jasepulveda-18/Proyecto_3_arq/evidence/para_informe/figuras_informe/comparacion_layouts.png

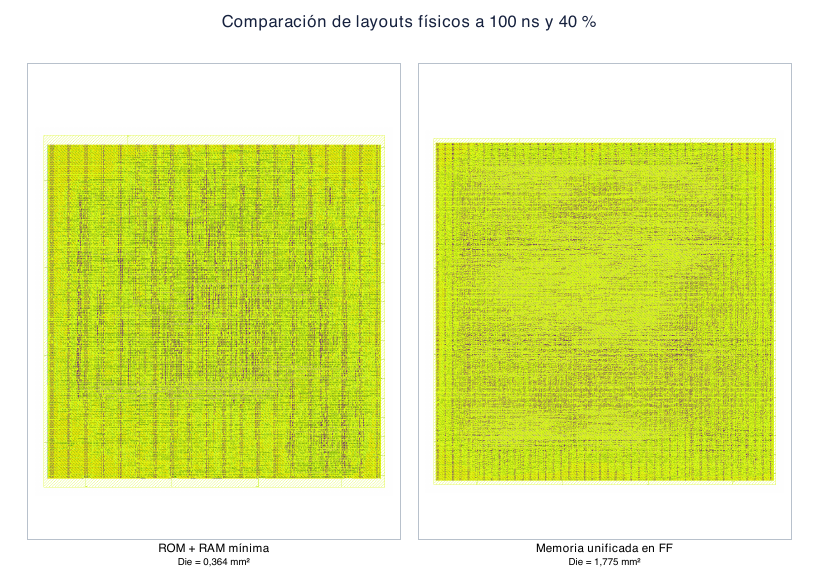
evidence/para_informe/figuras_informe/comparacion_layouts.png
