jasepulveda-18/Proyecto_3_arq/evidence/para_informe/layouts/congestion/rudy_40.png

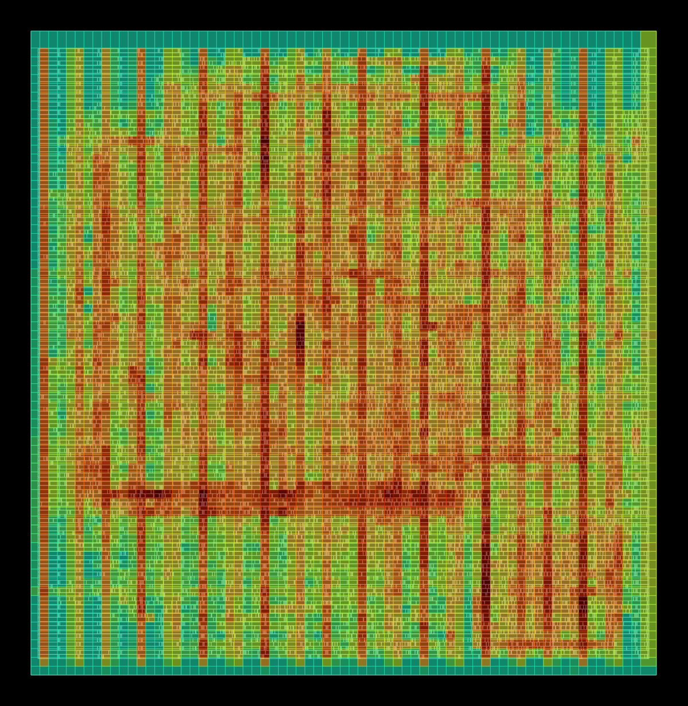
evidence/para_informe/layouts/congestion/rudy_40.png
