jasepulveda-18/Proyecto_3_arq/evidence/para_informe/figuras_informe/barrido_floorplan.pdf

# Barrido de floorplan: utilización frente a violaciones

-0.1

0.0

0.1

0.3

0.4

0.5

36.5673 | 47.8596 | 58.7342

Routing DRC

### Utilización real del core (%)

### Violaciones de routing DRC

Die 0,481 mm² | Die 0,364 mm² | Die 0,294 mm²
