jasepulveda-18/Proyecto_3_arq/evidence/para_informe/figuras_informe/barrido_timing.pdf

Barrido temporal de la estrategia ROM

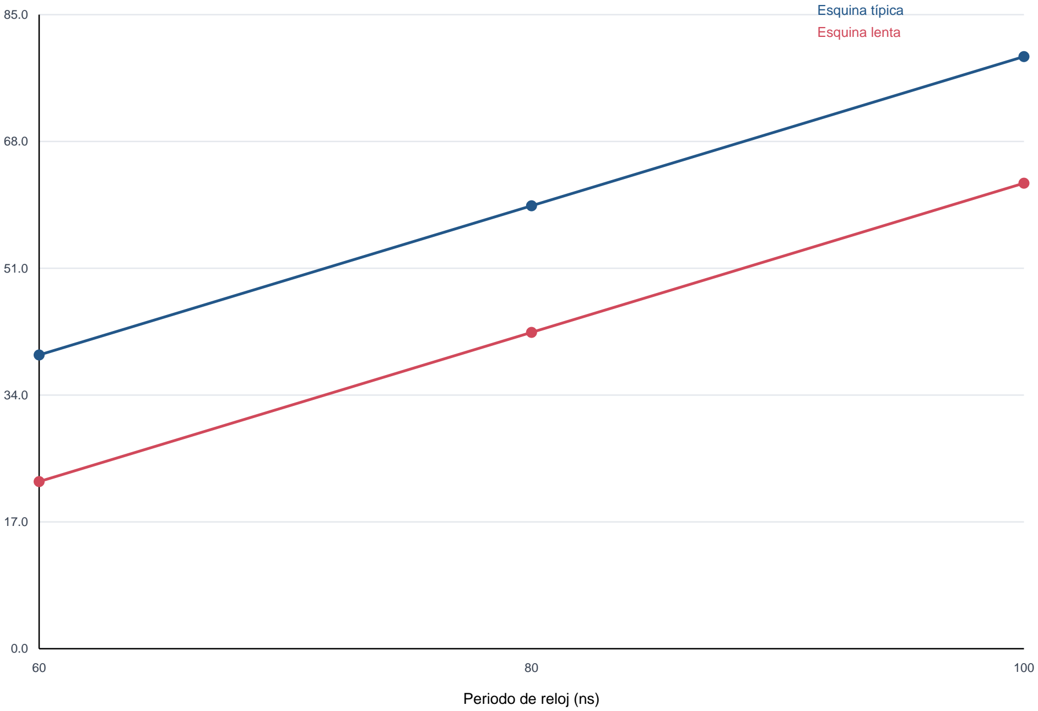
[picture p3: figure]
Esquina típica Esquina lenta; Periodo de reloj (ns)

Holgura real de setup (ns)
