jasepulveda-18/Proyecto_3_arq/evidence/para_informe/figuras_informe/comparacion_layouts.pdf

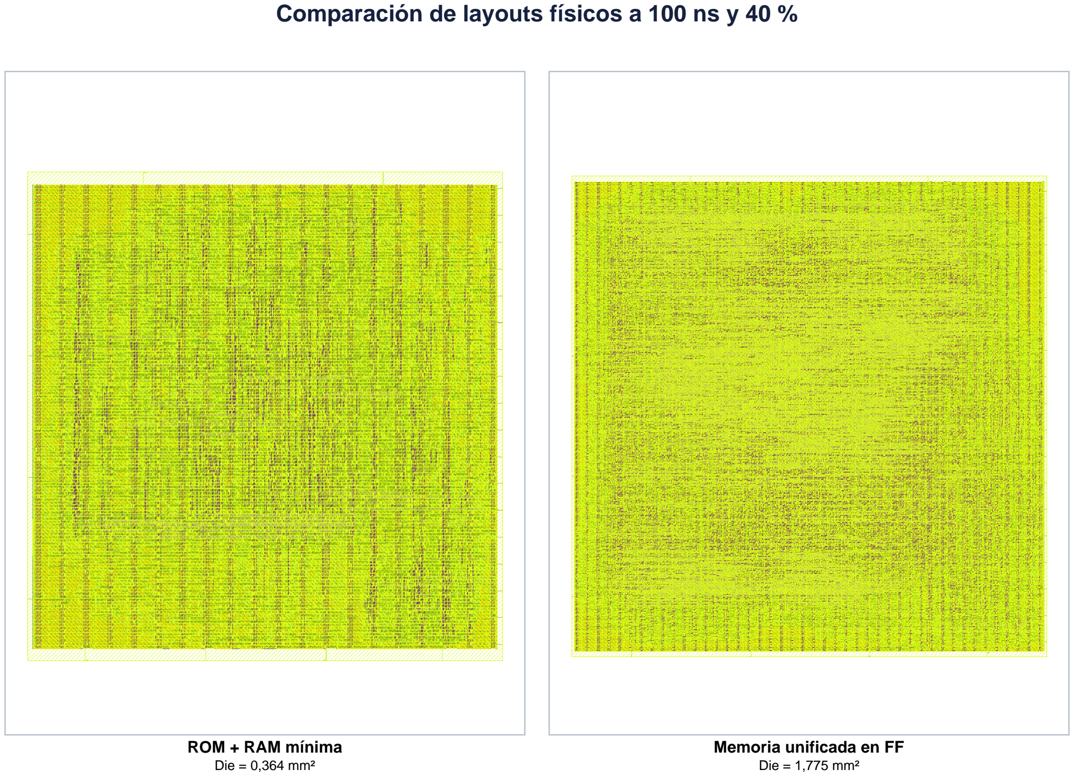
[picture p4: page 1]

Comparación de layouts físicos a 100 ns y 40 %

ROM + RAM mínima
Die = 0,364 mm²

Memoria unificada en FF
Die = 1,775 mm²
