jasepulveda-18/Proyecto_3_arq/evidence/para_informe/figuras_informe/comparacion_optimizacion_rtl.pdf

# Efecto medido de la optimización RTL

## Área: disminuye

Antes | Después

Área (µm²)

135.101 129.172

Lógica sintetizada

364.210
348.811

Die final

Reducción: 4,39 % en lógica y 4,23 % en die

## Retardo de la ruta crítica: aumenta

Antes | Después
Retardo (ns) | 20,62

21,66

Esquina típica

37,59

39,46

Esquina lenta

Ahorra área, pero no mejora la frecuencia

ROM, período 100 ns y utilización objetivo 40 %. Ambas corridas terminan sin DRC ni LVS.
