jasepulveda-18/Proyecto_3_arq/evidence/para_informe/figuras_informe/barrido_floorplan.png

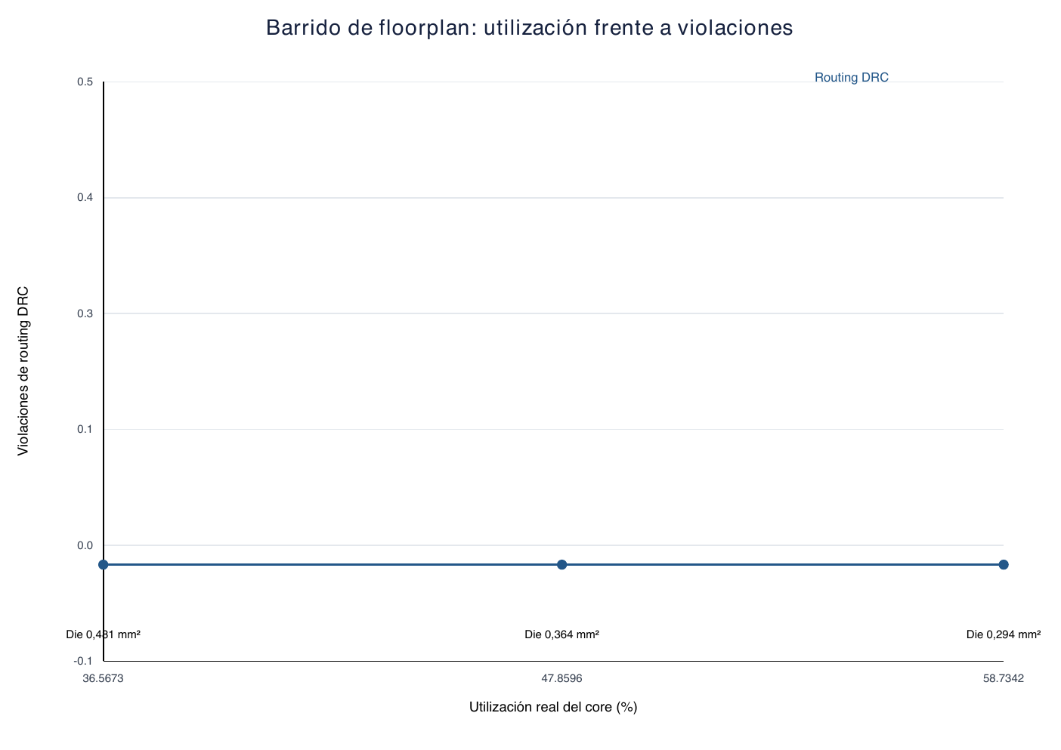
evidence/para_informe/figuras_informe/barrido_floorplan.png
