jasepulveda-18/Proyecto_3_arq/evidence/para_informe/layouts/congestion/comparacion_congestion_30_40_50.png

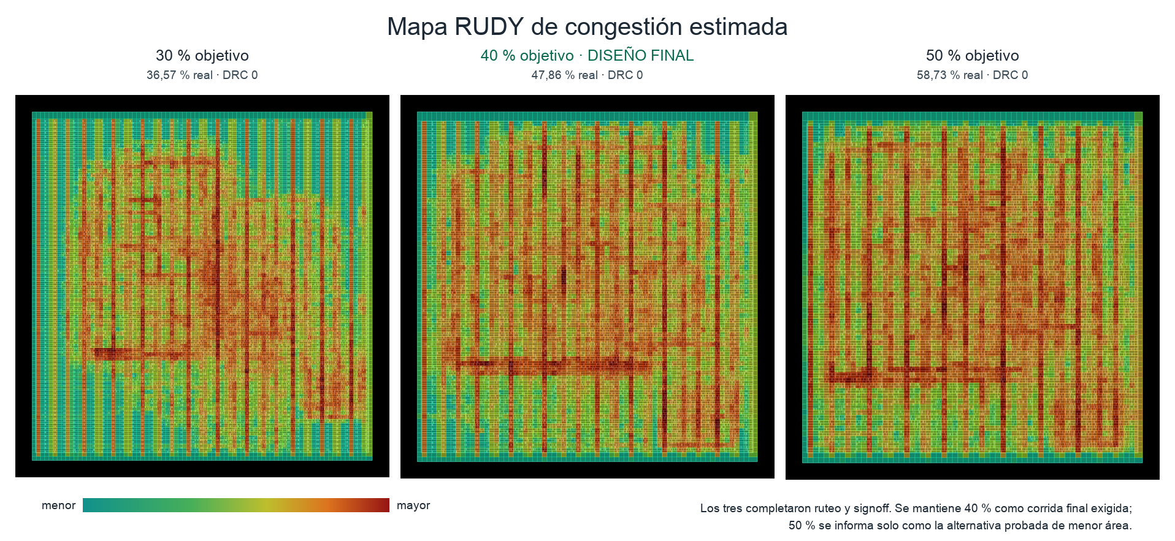
evidence/para_informe/layouts/congestion/comparacion_congestion_30_40_50.png
