jasepulveda-18/Proyecto_3_arq/evidence/para_informe/layouts/congestion/rudy_30.png

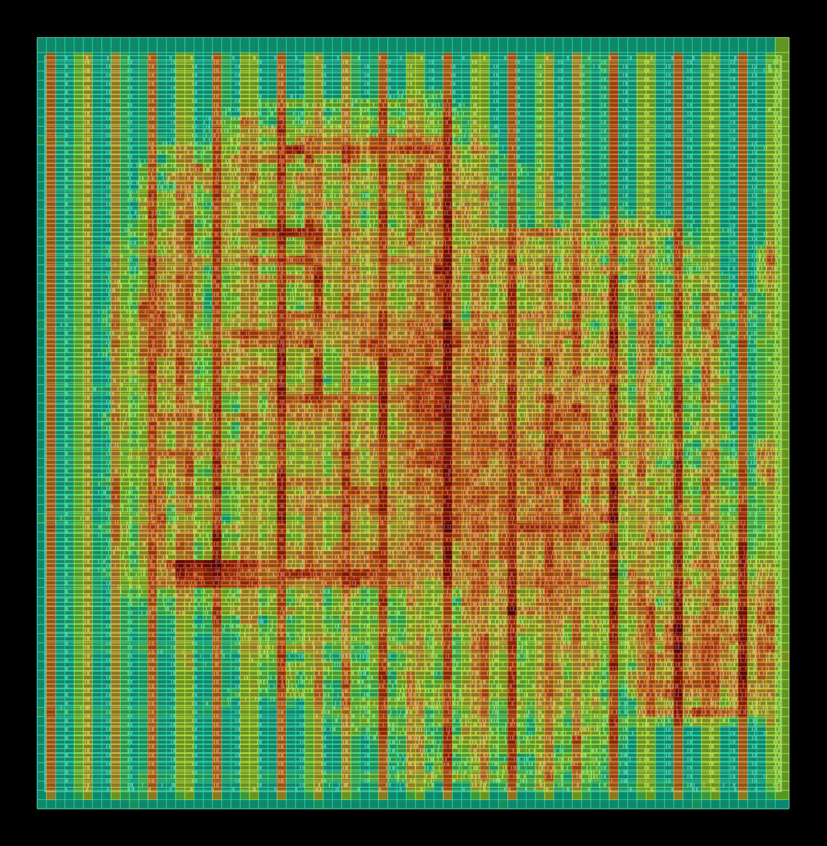
evidence/para_informe/layouts/congestion/rudy_30.png
