jasepulveda-18/Proyecto_3_arq/evidence/para_informe/layouts/congestion/rudy_50.png

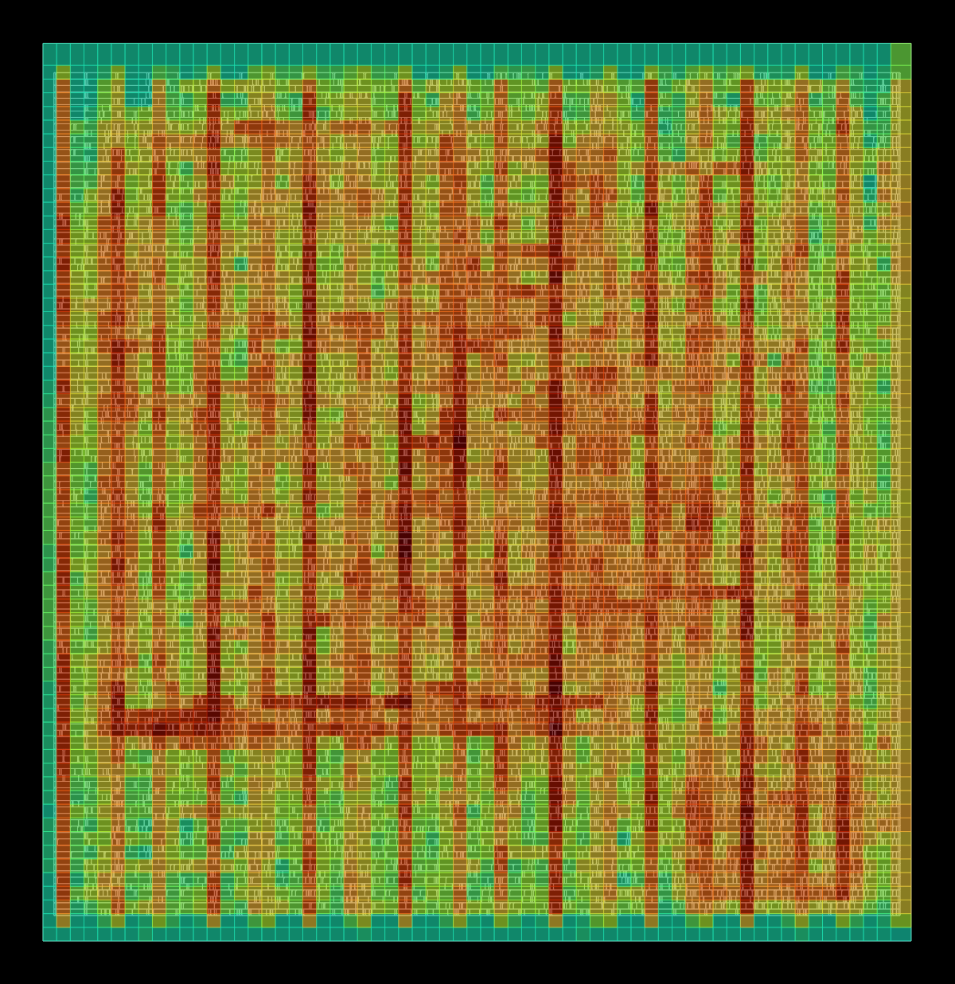
evidence/para_informe/layouts/congestion/rudy_50.png
