jasepulveda-18/Proyecto_3_arq/evidence/para_informe/layouts/layout_anotado_registros_contador.png

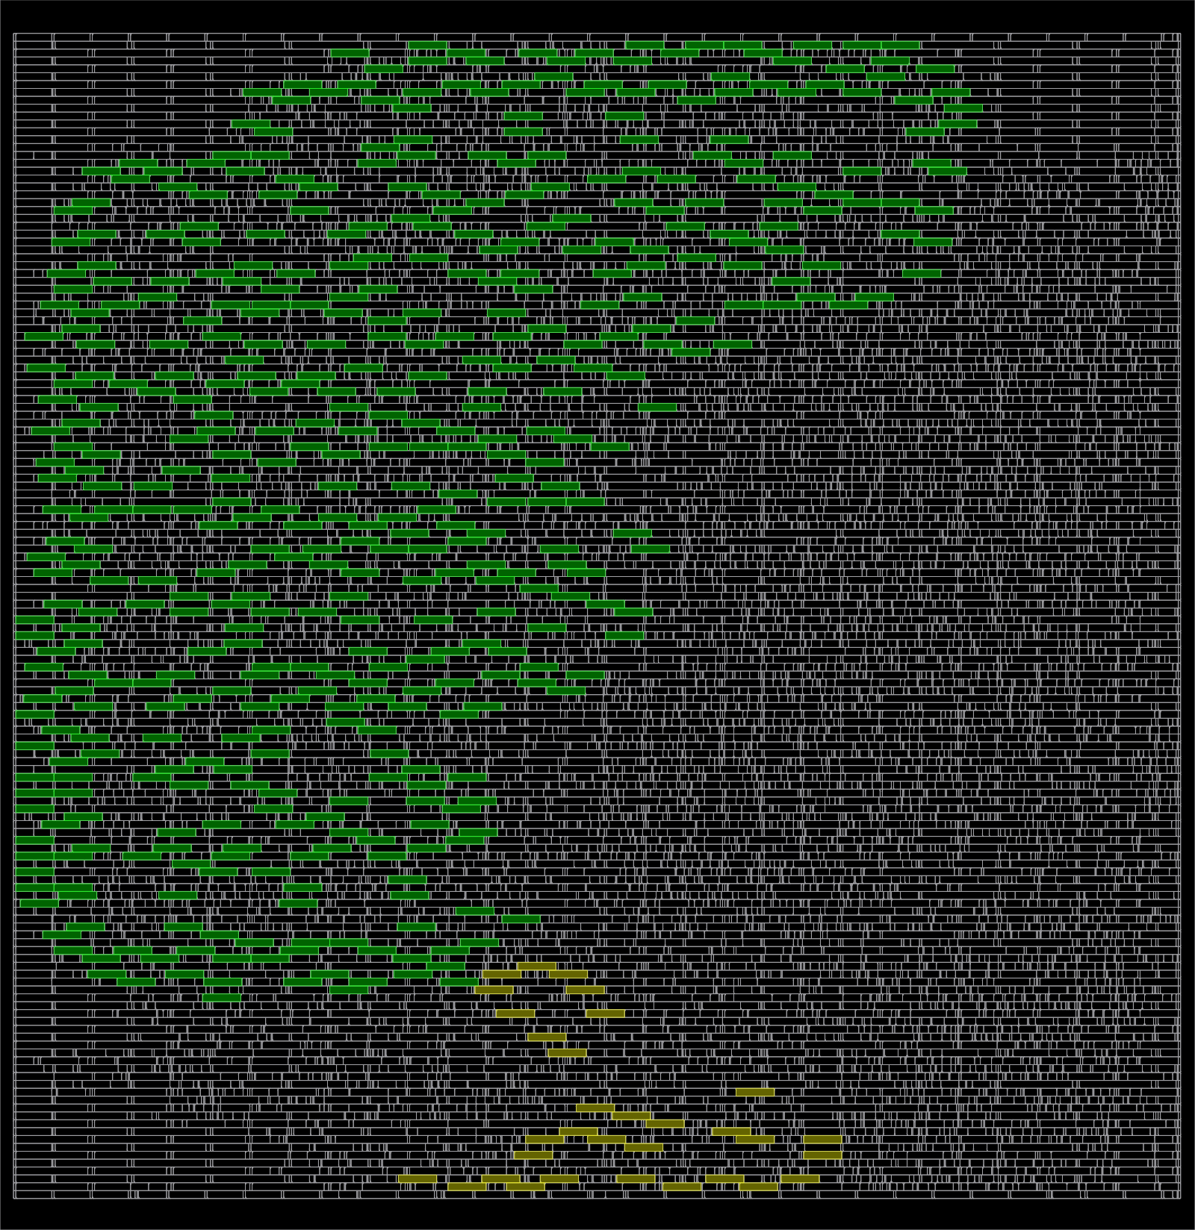
evidence/para_informe/layouts/layout_anotado_registros_contador.png
