jasepulveda-18/Proyecto_3_arq/evidence/para_informe/layouts/mapa_congestion_rudy_40.png

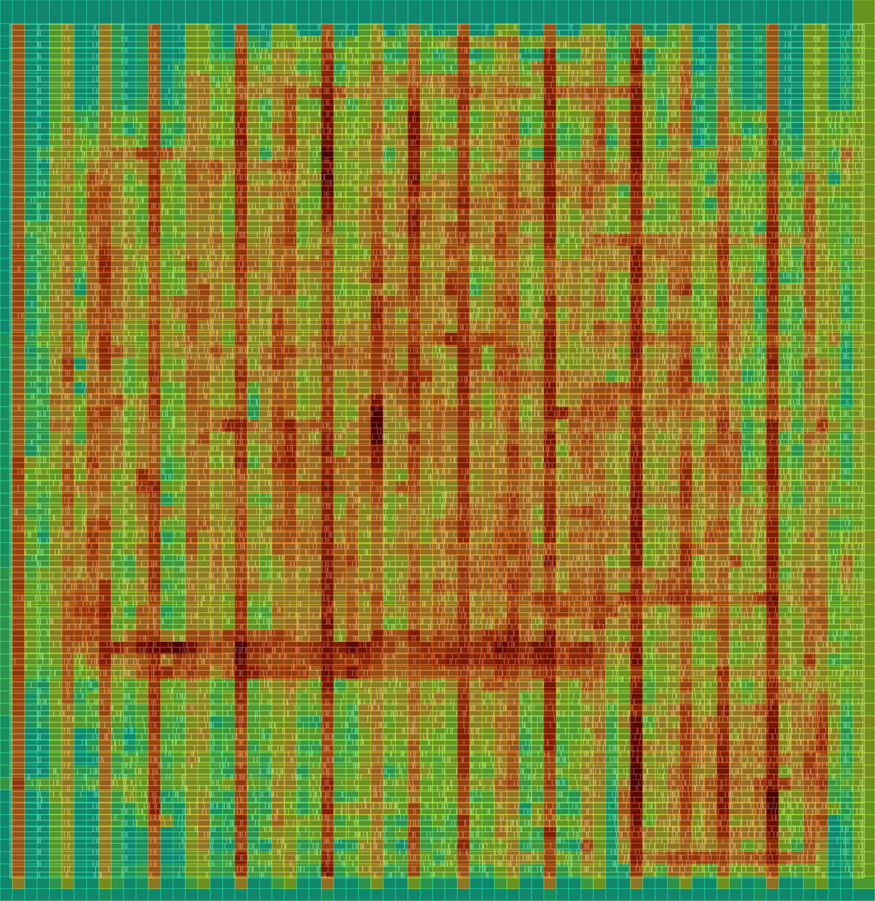
evidence/para_informe/layouts/mapa_congestion_rudy_40.png
