jasepulveda-18/Proyecto_3_arq/evidence/para_informe/layouts/unificada_final.png

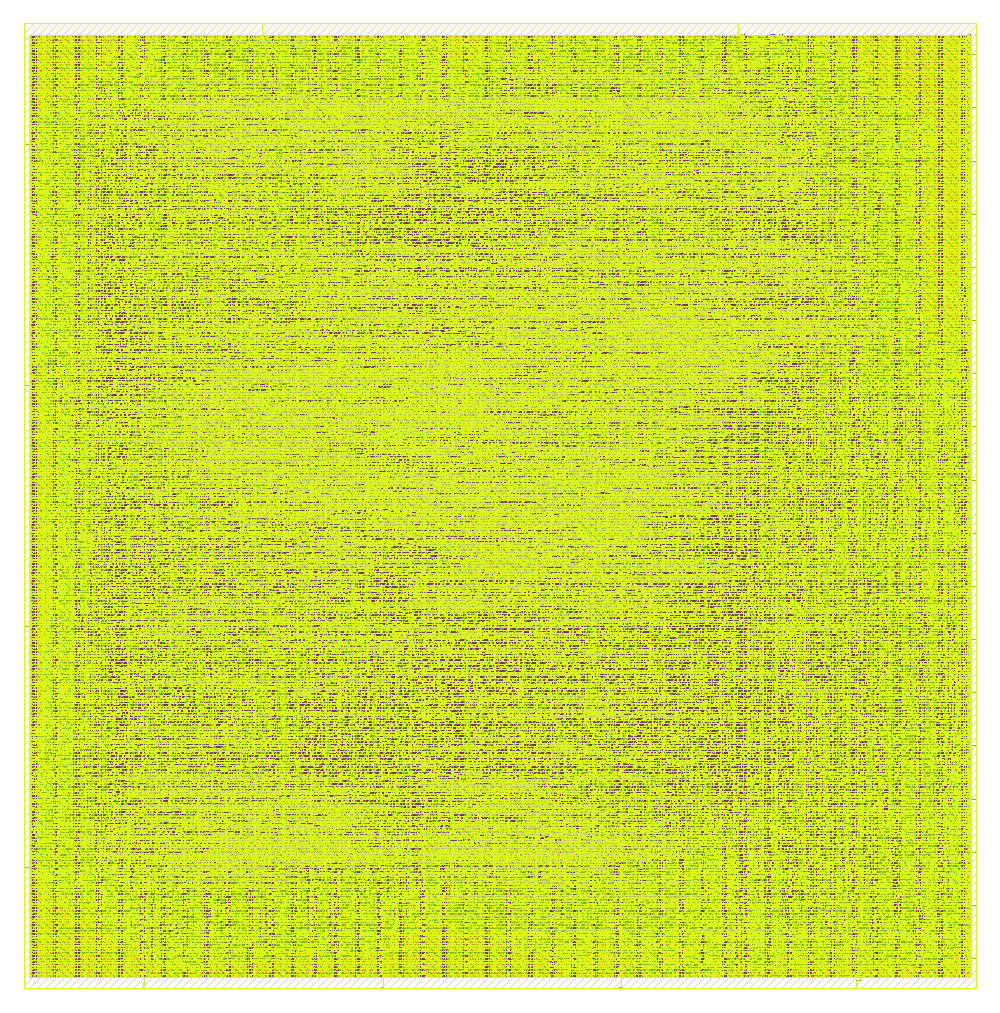
evidence/para_informe/layouts/unificada_final.png
