jasepulveda-18/Proyecto_3_arq/evidence/para_informe/optimizacion_rtl/layout_optimizado.png

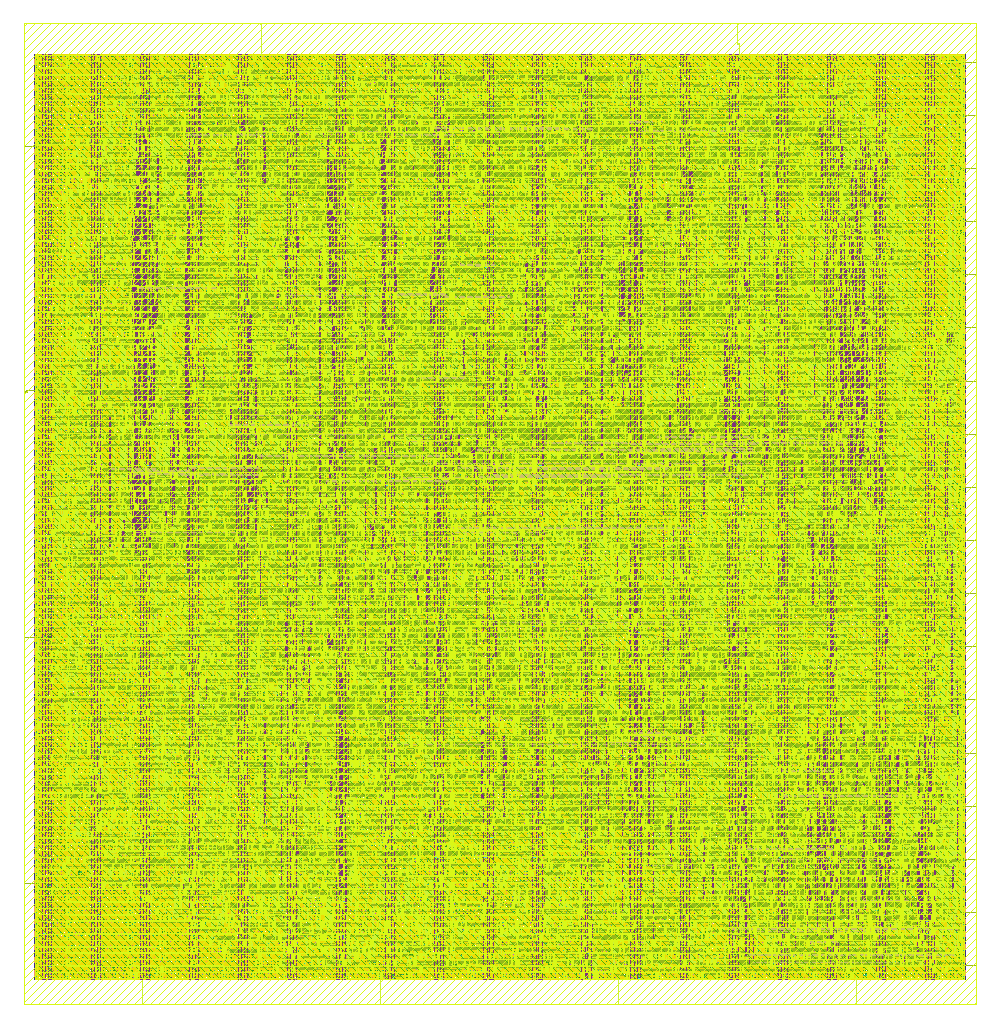
evidence/para_informe/optimizacion_rtl/layout_optimizado.png
