jasepulveda-18/Proyecto_3_arq/evidence/para_informe/capturas_terminal/captura_make_asic_check.png

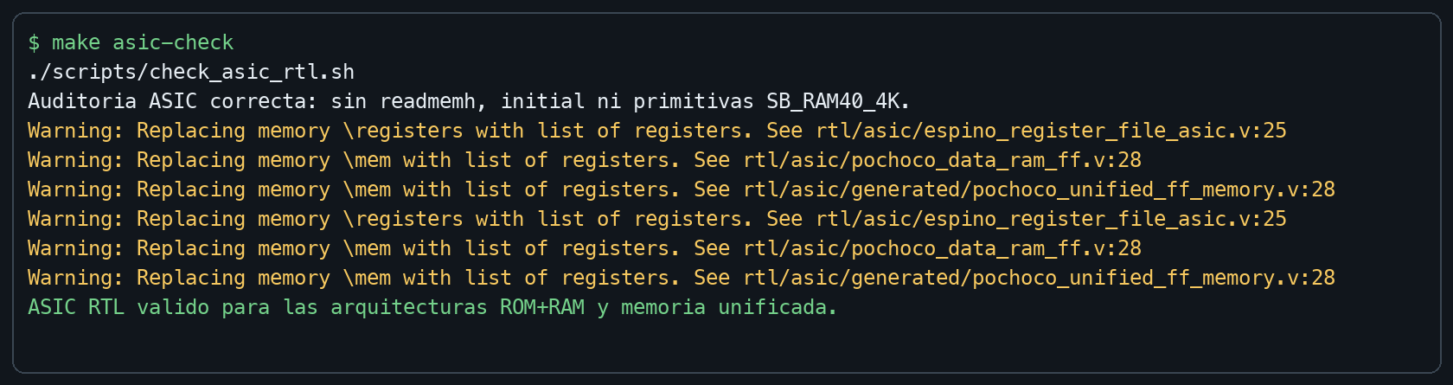
evidence/para_informe/capturas_terminal/captura_make_asic_check.png
