jasepulveda-18/Proyecto_3_arq/evidence/para_informe/capturas_terminal/captura_make_test_12_pruebas.png

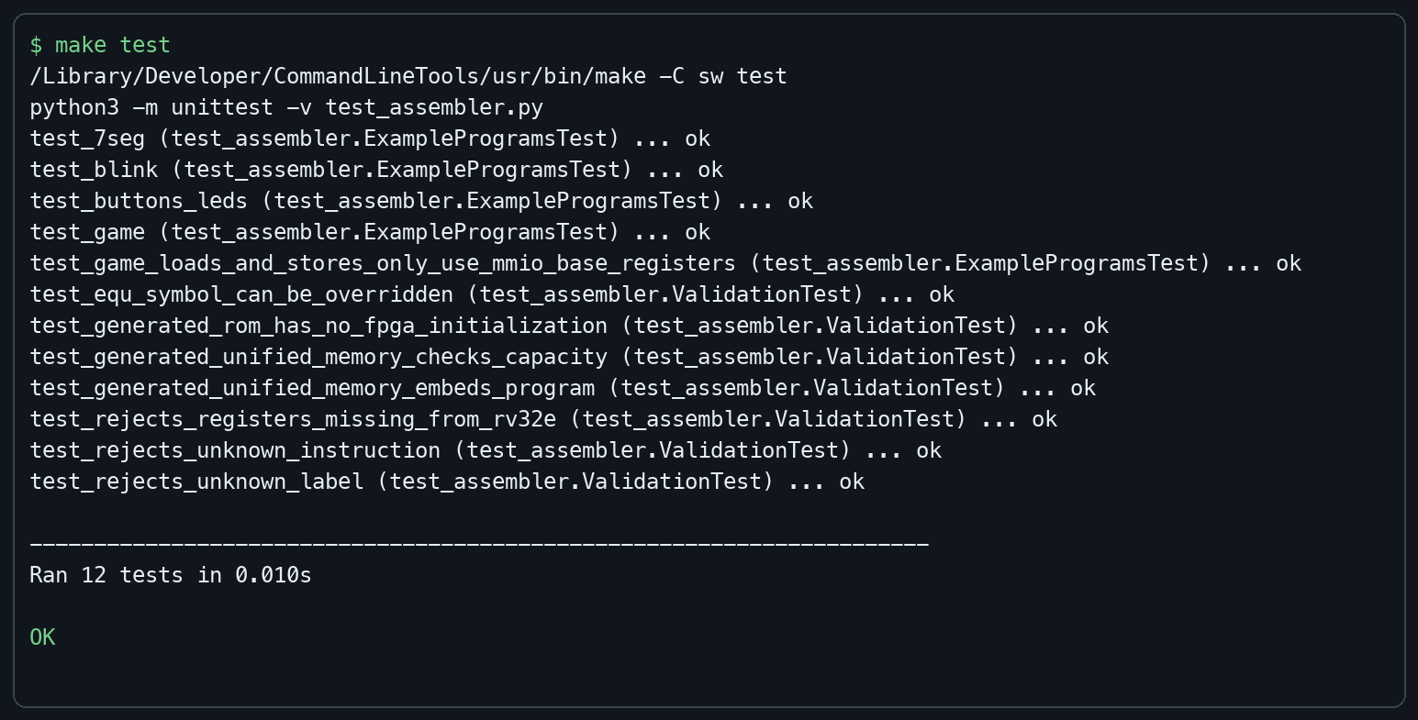
evidence/para_informe/capturas_terminal/captura_make_test_12_pruebas.png
