jasepulveda-18/Proyecto_3_arq/librelane/config_base.yaml

meta:
  version: 3
  flow: Classic

DESIGN_NAME: asic_top
VERILOG_FILES:
  - dir::../rtl/espino_core/espino_alu.v
  - dir::../rtl/espino_core/espino_controller.v
  - dir::../rtl/espino_core/espino_core.v
  - dir::../rtl/espino_core/espino_decoder.v
  - dir::../rtl/espino_core/espino_id_stage.v
  - dir::../rtl/espino_core/espino_if_stage.v
  - dir::../rtl/espino_core/espino_load_store_unit.v
  - dir::../rtl/asic/espino_register_file_asic.v
  - dir::../rtl/pochoco_cycle_counter.v
  - dir::../rtl/pochoco_periph.v
  - dir::../rtl/pochoco_spi_slave.v
  - dir::../rtl/asic/pochoco_data_ram_ff.v
  - dir::../rtl/asic/pochoco_soc_asic.v
  - dir::../rtl/asic/asic_top.v
  - dir::../rtl/asic/generated/pochoco_game_rom.v
  - dir::../rtl/asic/generated/pochoco_unified_ff_memory.v

CLOCK_PORT: clk_i
CLOCK_PERIOD: 100
FP_CORE_UTIL: 40
PL_TARGET_DENSITY_PCT: 50
SYNTH_HIERARCHY_MODE: flatten

PNR_SDC_FILE: dir::constraints.sdc
SIGNOFF_SDC_FILE: dir::constraints.sdc
FALLBACK_SDC: dir::constraints.sdc
IO_PIN_ORDER_CFG: dir::pin_order.cfg

# Parametros conservadores para el bloque logico sin pads.
PDN_MULTILAYER: false
PDN_ENABLE_PINS: true
PDN_VOFFSET: 5
PDN_HOFFSET: 5
PDN_VWIDTH: 2
PDN_HWIDTH: 2
PDN_VPITCH: 30
PDN_HPITCH: 30
DRT_ANTENNA_REPAIR_ITERS: 10
DRT_ANTENNA_REPAIR_MARGIN: 10

pdk::gf180mcu*:
  MAX_FANOUT_CONSTRAINT: 4
